mlanagan/RemoteHF/BARC Remote HF Presentation.pptx

## BARC Remote HF

## System Schematic – No Remote HF

SteppIR

40/80m EFHW

Rotator
Pwr/Signals

SDA100

Yeasu
G-800DXA

Feed Line

CI-V
Freq Info

Feed Line

ANT
SW

IC7300

## System Schematic – With Remote HF

SteppIR

40/80m EFHW

Rotator
Pwr/Signals

Yeasu
G-800DXA

SDA100

Data In

Feed Line

Feed Line

Data Out

Rot Ext Ctrl

Internet

Home PC

USB

Remote HF

CI-V
Freq Info

IC7300

Feed Line

## Home PC – Antenna/Rotator Control

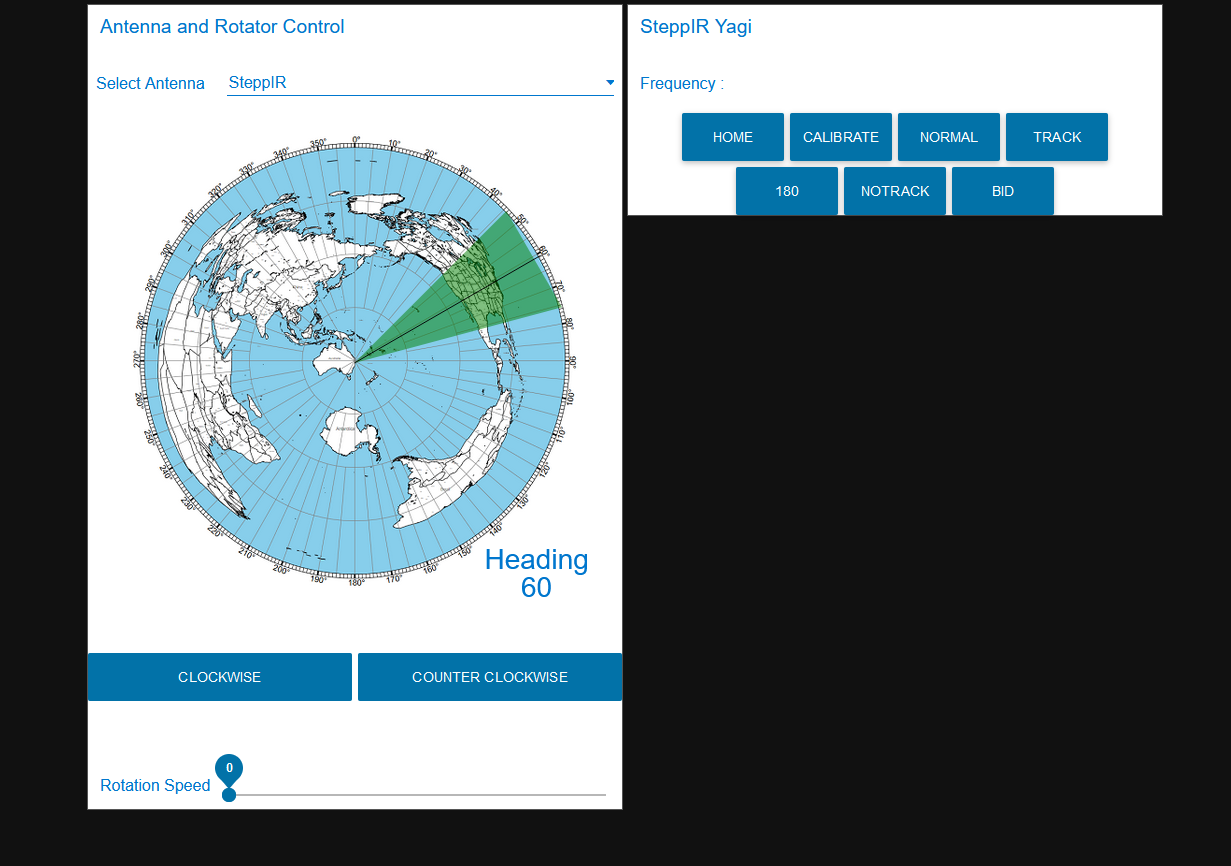
[picture p1: figure]

Select Antenna

Control the SteppIR

Current Antenna Heading

Rotate the Antenna
CW/CCW

Control the speed of rotation

## Home PC – WFView

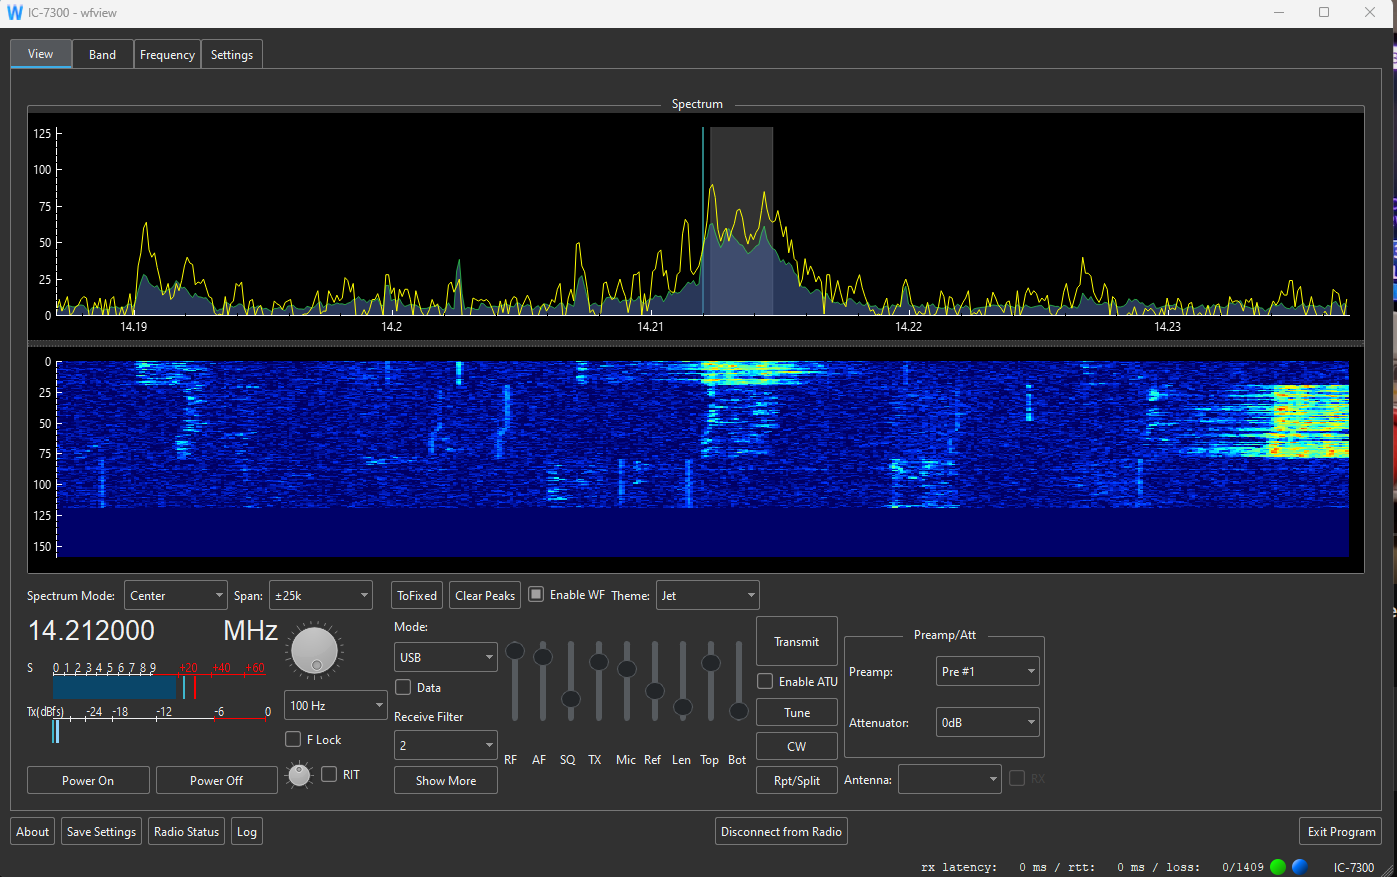
[picture p2: figure]

Frequency Graph

Waterfall

PTT

Frequency/S Meter/

Soft power on/off the radio

Radio settings

## Permissions

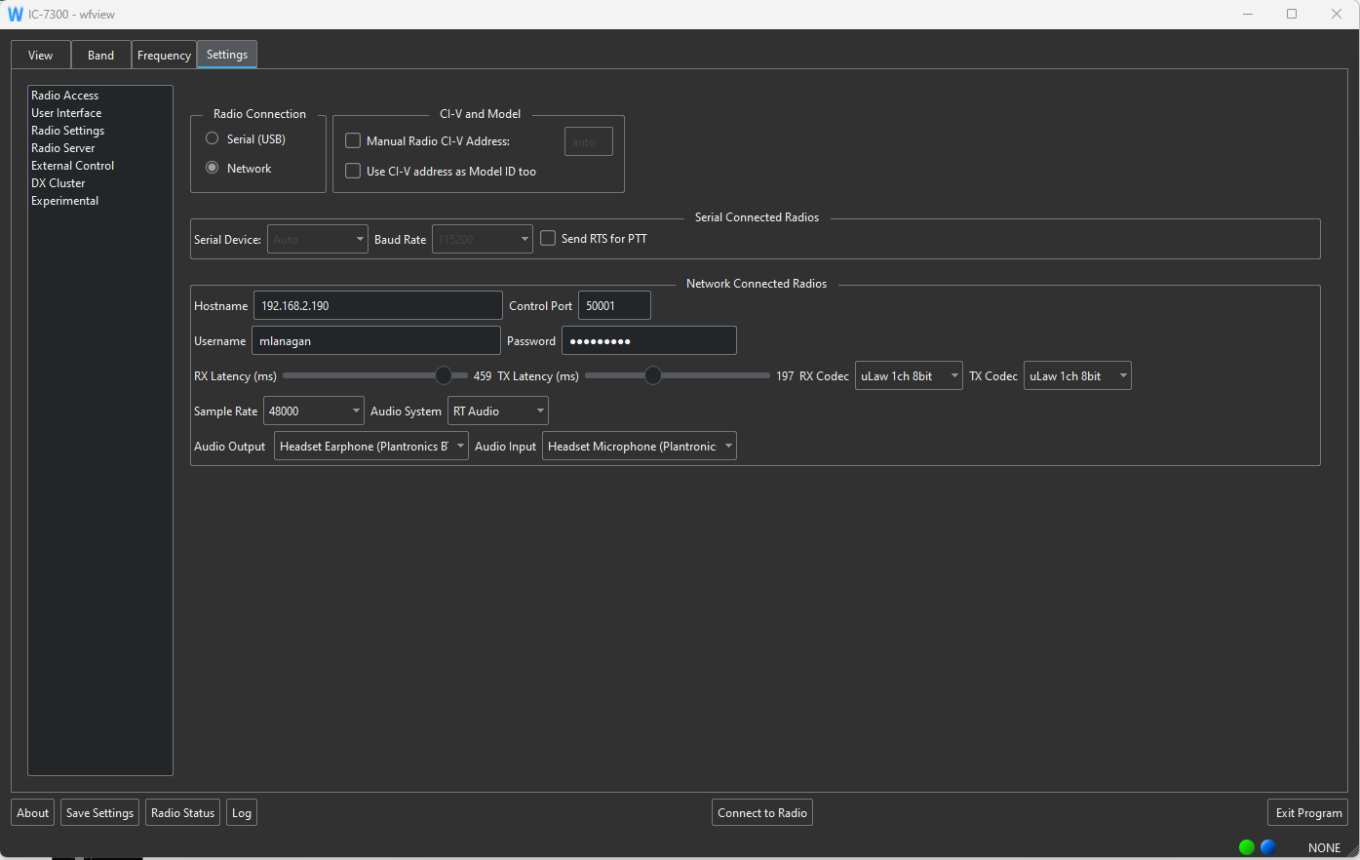
[picture p3: figure]

## VPN
