mlanagan/RemoteHF/NodeRed/Azimuthal Map 500 pixel.png

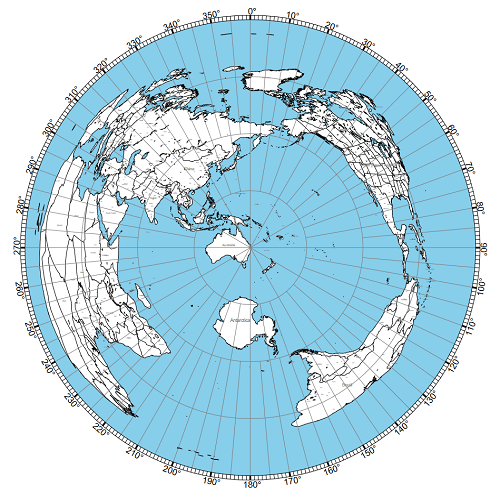
NodeRed/Azimuthal Map 500 pixel.png
