mlanagan/RemoteHF/Simulations/Linear DC Signal Opto-Isolator _ Optocoupler Circuit.png

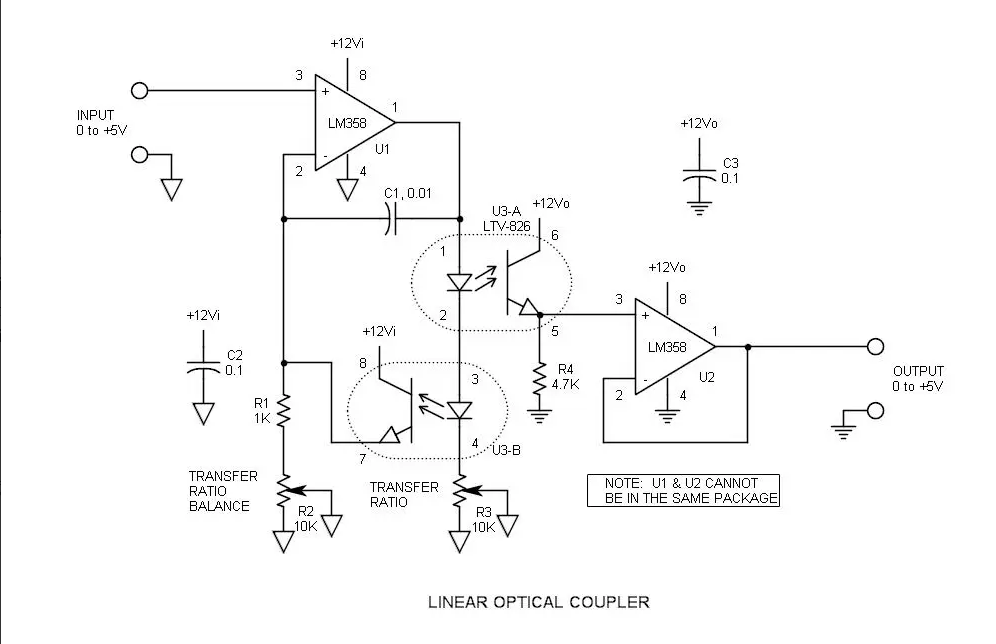
Simulations/Linear DC Signal Opto-Isolator _ Optocoupler Circuit.png
