mlanagan/RemoteHF/Costs/Remote HF Costs.xlsx

Item | Purchase Cost | QTY Ordered | Single Cost | QTY Used | Cost | Invoice | Notes
PCB - Remote HF | $44.40 | 5 | $8.88 | 5 | $44.40 | Remote HF invoice.pdf | Only used 1, but included full cost as part of the project
PCB - Remote HF PSU | $15.26 | 5 | $3.05 | 5 | $15.26 | Remote HF PSU invoice.pdf | Only used 2, but included full cost as part of the project
SMA Connectors | $31.00 | 5 | $6.20 | 5 | $31.00 | 7037128.pdf
STANDOFF, HEX FEMALE M2.5 | $7.62 | 10 | $0.76 | 4 | $3.05 | 7037128.pdf | Included what was used, remainder to VK4MWL spares
Pan Head Screw M2.5 | $3.58 | 100 | $0.04 | 8 | $0.29 | 7037128.pdf | Included what was used, remainder to VK4MWL spares
L7812CV | $3.08 | 5 | $0.62 | 2 | $1.23 | 7116739.pdf | Included what was used, remainder to VK4MWL spares
T491A224K035AT CAP, 0.22μF | $3.51 | 10 | $0.35 | 4 | $1.40 | 7116739.pdf | Included what was used, remainder to VK4MWL spares
TIP42C TRANSISTOR | $8.70 | 6 | $1.45 | 2 | $2.90 | 7116739.pdf | Included what was used, remainder to VK4MWL spares
ESK108M035AL3AA CAP, 1000μF | $8.25 | 10 | $0.82 | 4 | $3.30 | 7116739.pdf | Included what was used, remainder to VK4MWL spares
CONNECTOR, HEADER, 3POS | $4.21 | 10 | $0.42 | 2 | $0.84 | 7116739.pdf | Included what was used, remainder to VK4MWL spares
CONTACT, SOCKET | $2.94 | 30 | $0.10 | 6 | $0.59 | 7116739.pdf | Included what was used, remainder to VK4MWL spares
CRGCQ2512J3R3 RES, 3R3, 5%, 2512 | $3.77 | 10 | $0.38 | 2 | $0.75 | 7116739.pdf | Included what was used, remainder to VK4MWL spares
GBU401 BRIDGE RECTIFIER, 100V, 4A | $6.44 | 4 | $1.61 | 4 | $6.44 | 7116739.pdf
INLET, IEC, DPST, WITH FUSE HOLDER | $8.27 | 1 | $8.27 | 1 | $8.27 | 7111721.pdf
L7805CV | $2.58 | 5 | $0.52 | 2 | $1.03 | 7111721.pdf | Included what was used, remainder to VK4MWL spares
SIL PAD | $4.58 | 10 | $0.46 | 6 | $2.75 | 7111721.pdf | Included what was used, remainder to VK4MWL spares
31-35-25GFN BUSH, TO-220 | $2.24 | 10 | $0.22 | 6 | $1.34 | 7111721.pdf | Included what was used, remainder to VK4MWL spares
CONNECTOR, RCPT, 3POS | $1.01 | 10 | $0.10 | 2 | $0.20 | 7111721.pdf | Included what was used, remainder to VK4MWL spares
Heatsink Large | $24.88 | 2 | $12.44 | 2 | $24.88 | 8174468141636406.png
Heatsink Small | $8.34 | 1 | $8.34 | 1 | $8.34 | 8174468141656406.png
SO239 to SMA | $4.29 | 1 | $4.29 | 1 | $4.29 | 8168797981976406.png
SMA to SMA Cable | $2.39 | 1 | $2.39 | 1 | $2.39 | 8168672447006406.png
USB Isolator | $16.47 | 1 | $16.47 | 1 | $16.47 | 8163513651936406.png
PS2 Connector | $3.67 | 5 | $0.73 | 1 | $0.73 | 8158063447796406.png | Included what was used, remainder to VK4MWL spares
PS2 Cable | $11.32 | 1 | $11.32 | 1 | $11.32 | 8158063607796406.png
PCB Screw connectors | $5.23 | 10 | $0.52 | 4 | $2.09 | 8158380707686406.png | Included what was used, remainder to VK4MWL spares
Headers for Raspberry Pi | $7.27 | 10 | $0.73 | 1 | $0.73 | 8157976885486406.png | Included what was used, remainder to VK4MWL spares
DB9 Connectors | $2.65 | 2 | $1.32 | 1 | $1.32 | 8158428130806406.png | Included what was used, remainder to VK4MWL spares
NDS7002A MOSFETS | $15.55 | 50 | $0.31 | 17 | $5.29 | 8157449323486406.png | Included what was used, remainder to VK4MWL spares
MAX202 | $4.23 | 10 | $0.42 | 1 | $0.42 | 8157855993506406.png | Included what was used, remainder to VK4MWL spares
Rasberry Pi | $135.30 | 1 | $135.30 | 1 | $135.30 | 1000379996.png
Total | $403.03 |  |  |  | $338.63
