mlanagan/RemoteHF/Costs/Remote HF invoice.pdf

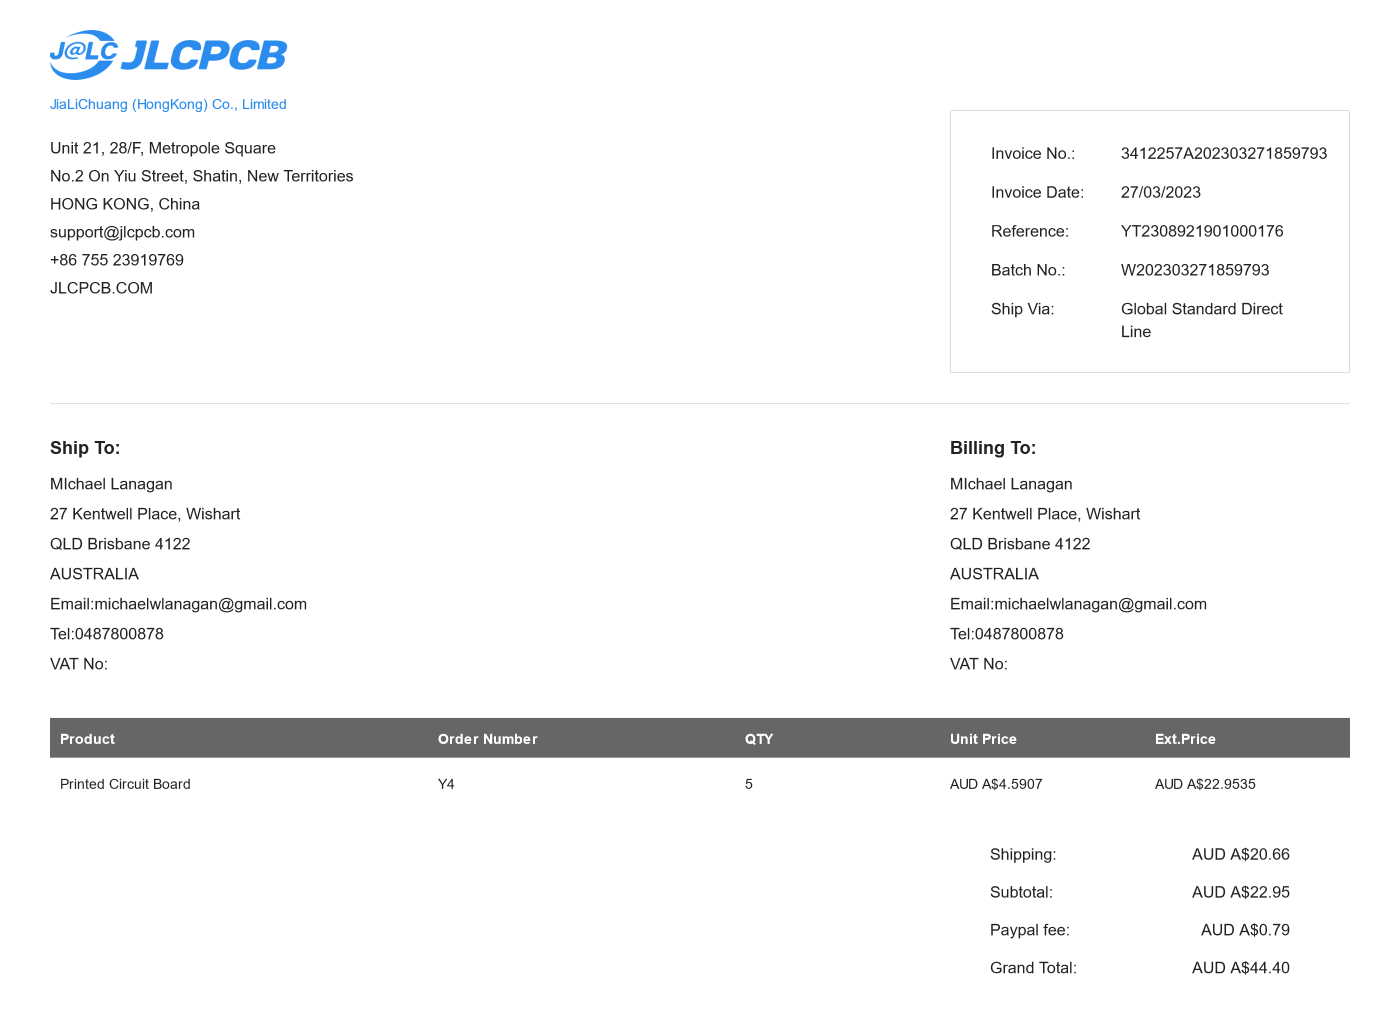
[picture p6: figure]
