mlanagan/RemoteHF/Costs/Remote HF PSU invoice.pdf

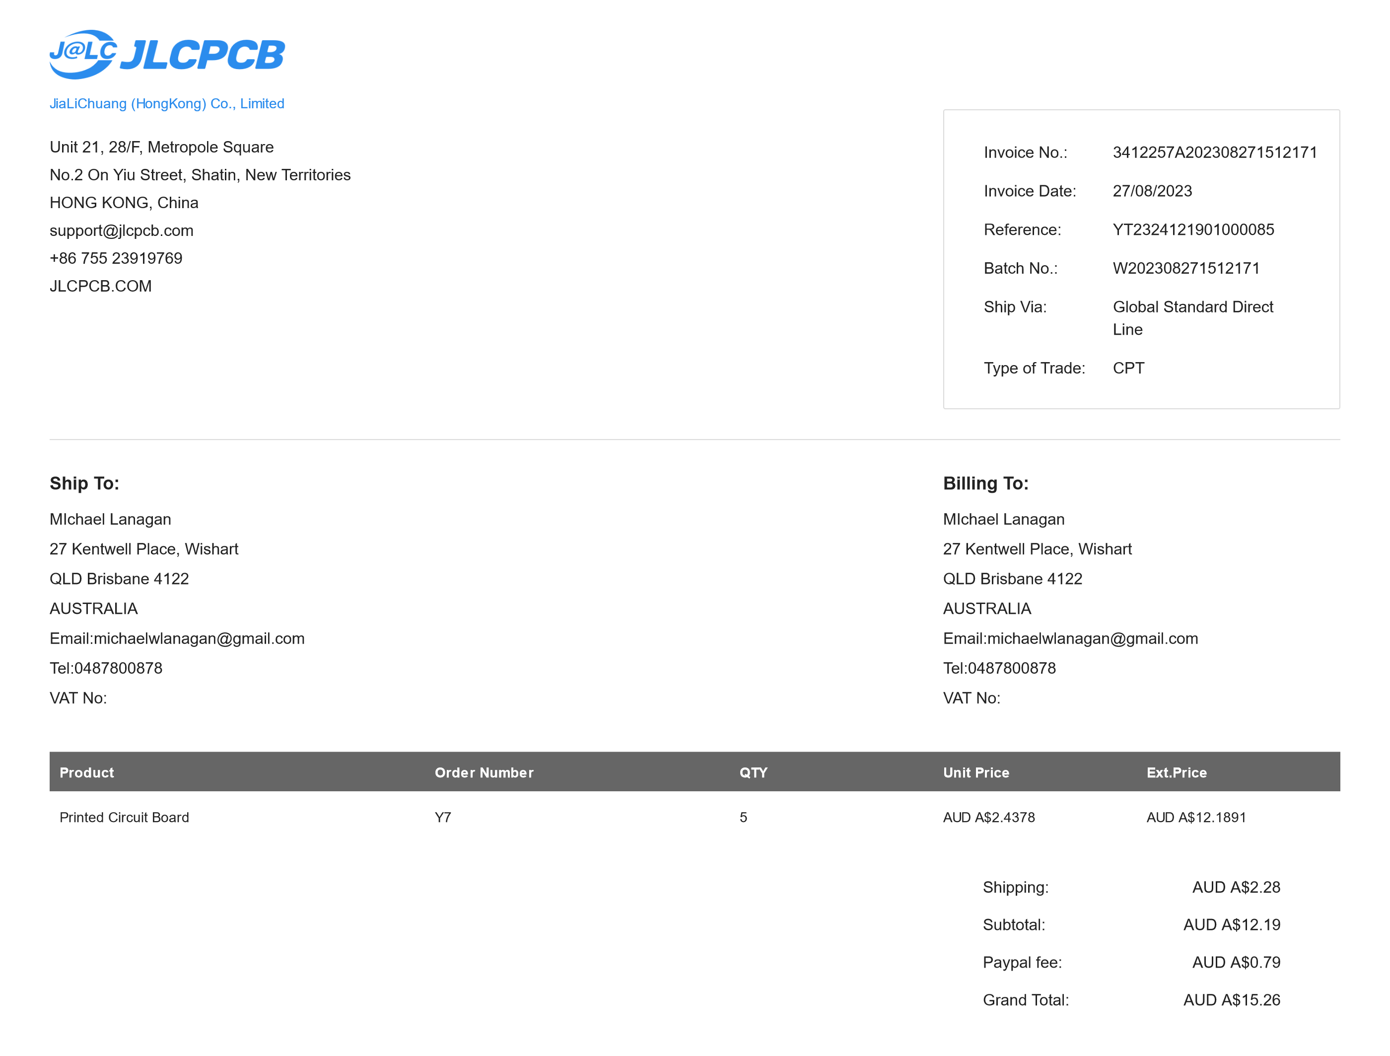
[picture p7: figure]
