mlanagan/RemoteHF/Costs/1000379996.png

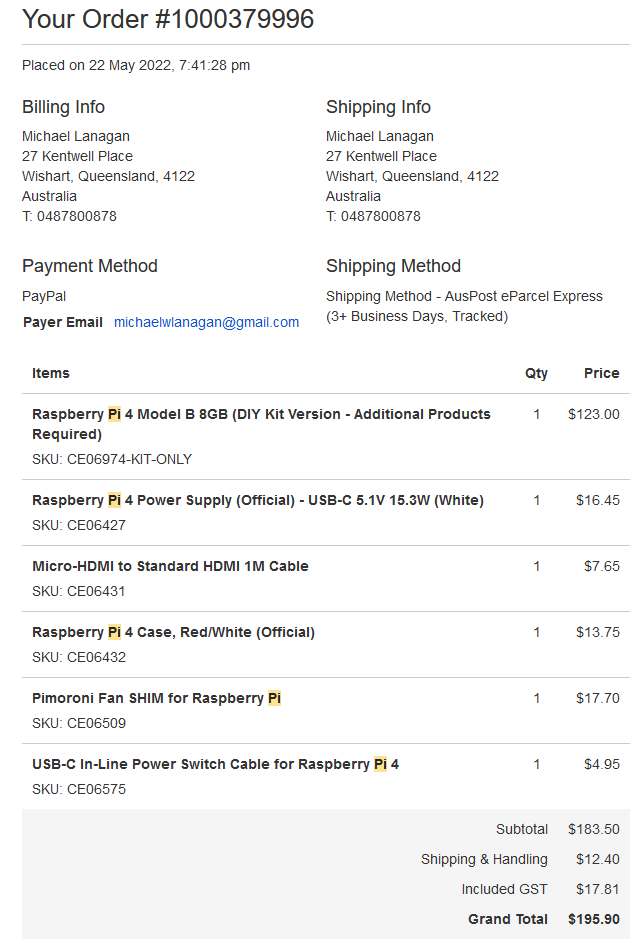
Costs/1000379996.png
