mlanagan/RemoteHF/Costs/8157449323486406.png

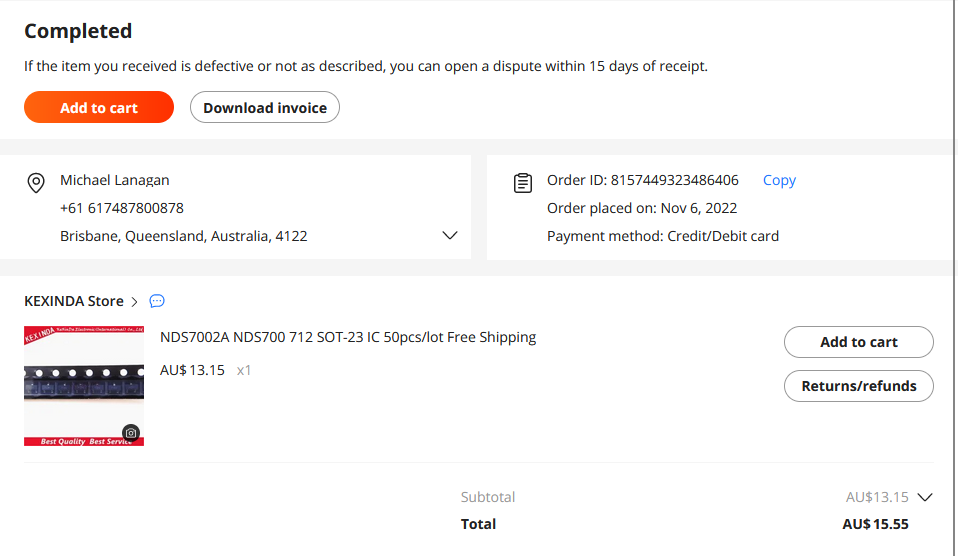
Costs/8157449323486406.png
