mlanagan/RemoteHF/Costs/8157855993506406.png

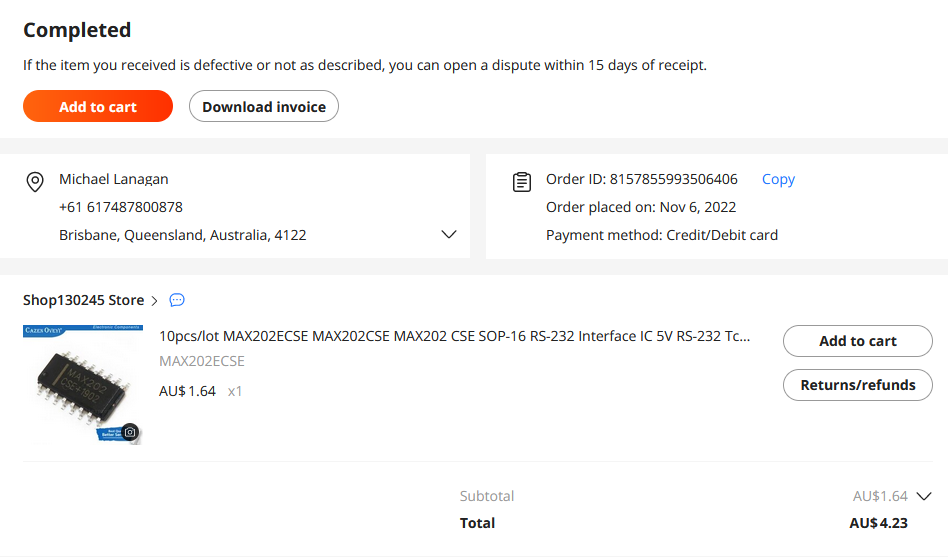
Costs/8157855993506406.png
