mlanagan/RemoteHF/Costs/8158063447796406.png

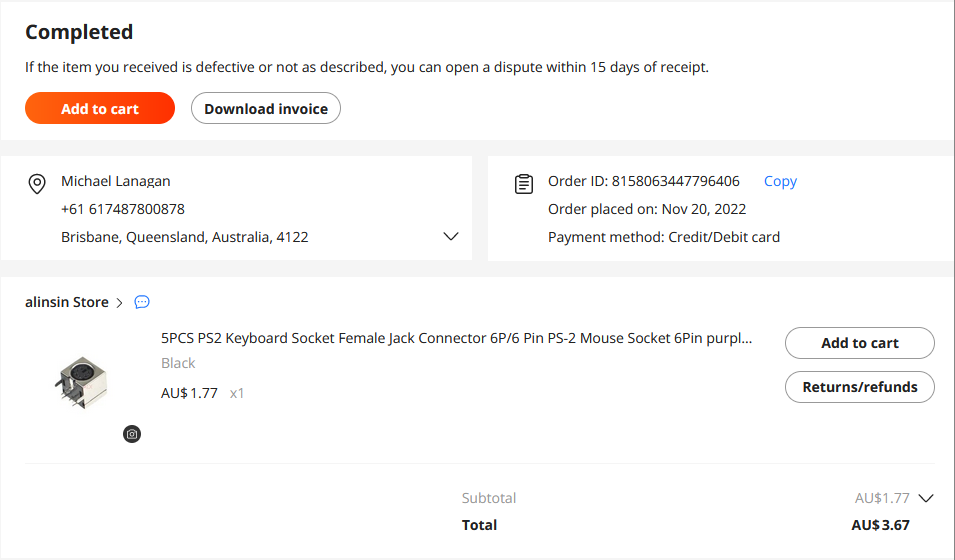
Costs/8158063447796406.png
