mlanagan/RemoteHF/Costs/8158380707686406.png

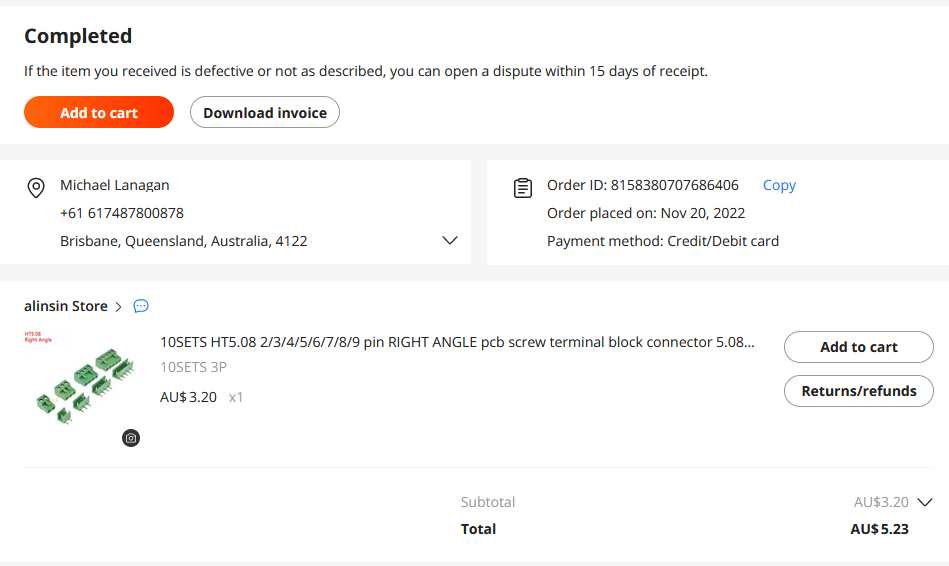
Costs/8158380707686406.png
