mlanagan/RemoteHF/Costs/8158428130806406.png

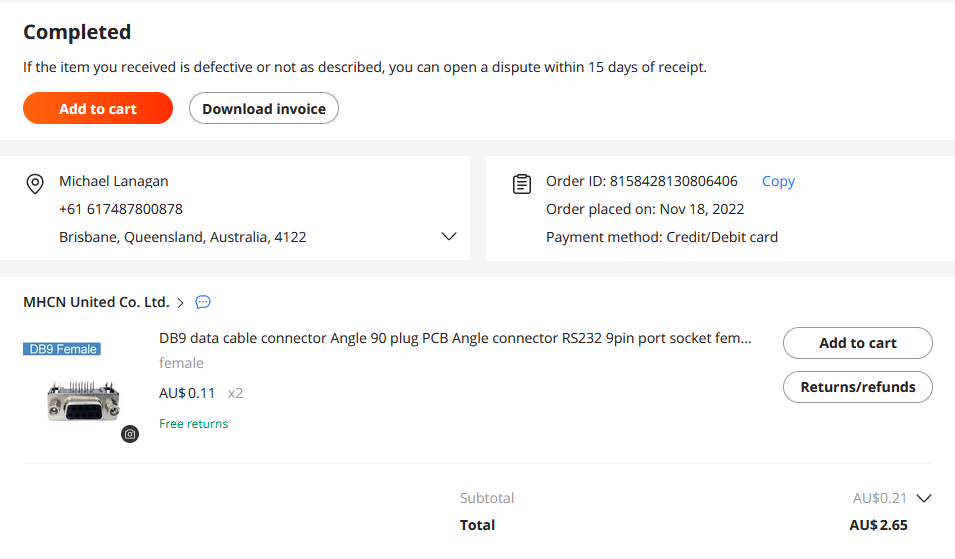
Costs/8158428130806406.png
