mlanagan/RemoteHF/Costs/8163513651936406.png

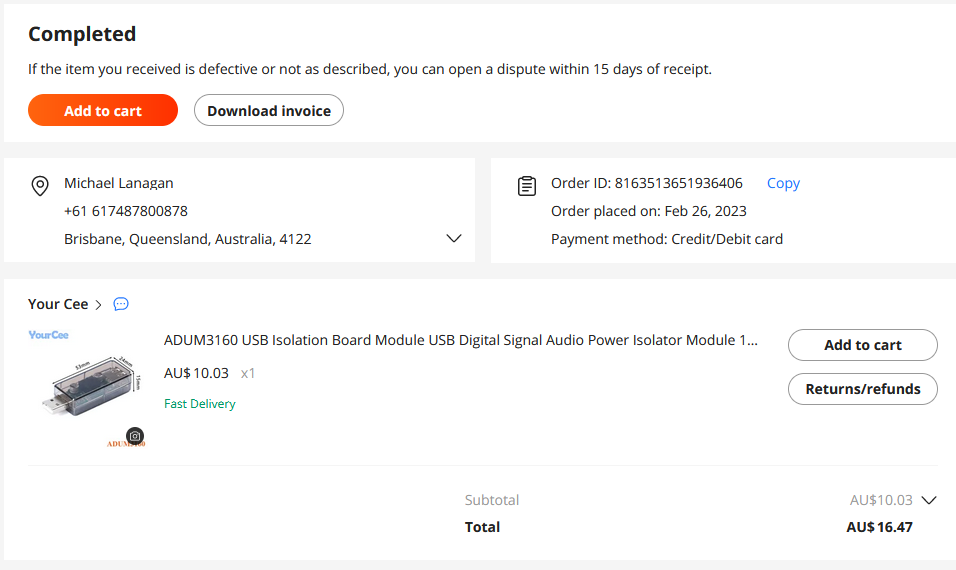
Costs/8163513651936406.png
