mlanagan/RemoteHF/Costs/8168672447006406.png

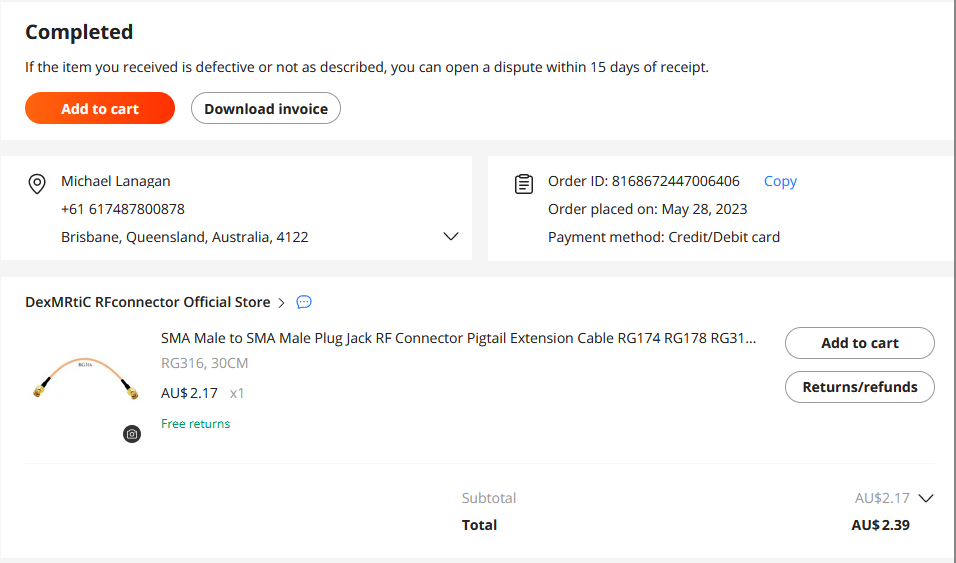
Costs/8168672447006406.png
