mlanagan/RemoteHF/Costs/8174468141636406.png

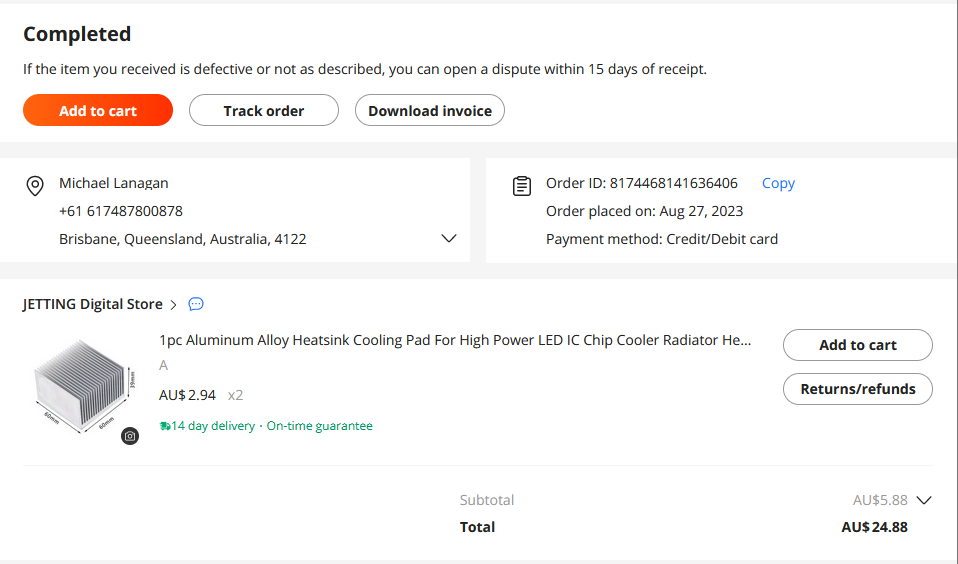
Costs/8174468141636406.png
