mlanagan/RemoteHF/Costs/8174468141656406.png

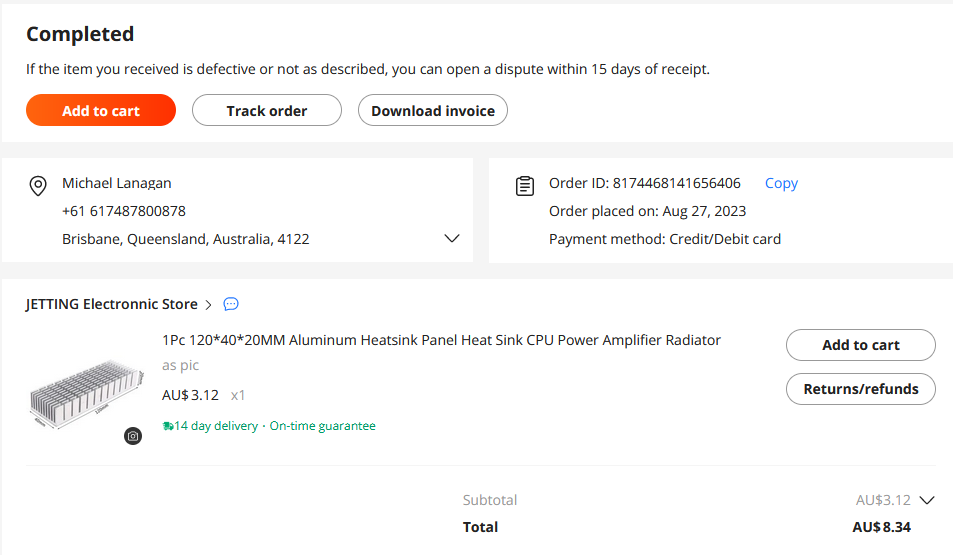
Costs/8174468141656406.png
