mlanagan/RemoteHF/NodeRed/Installed Nodes.png

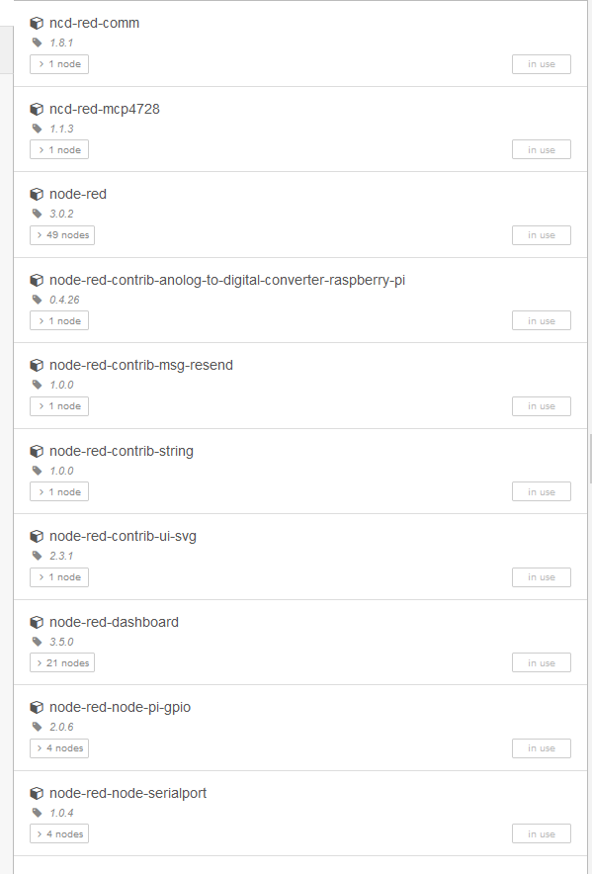
NodeRed/Installed Nodes.png
