mlanagan/RemoteHF/PowerSupply/PowerSupply.pdf

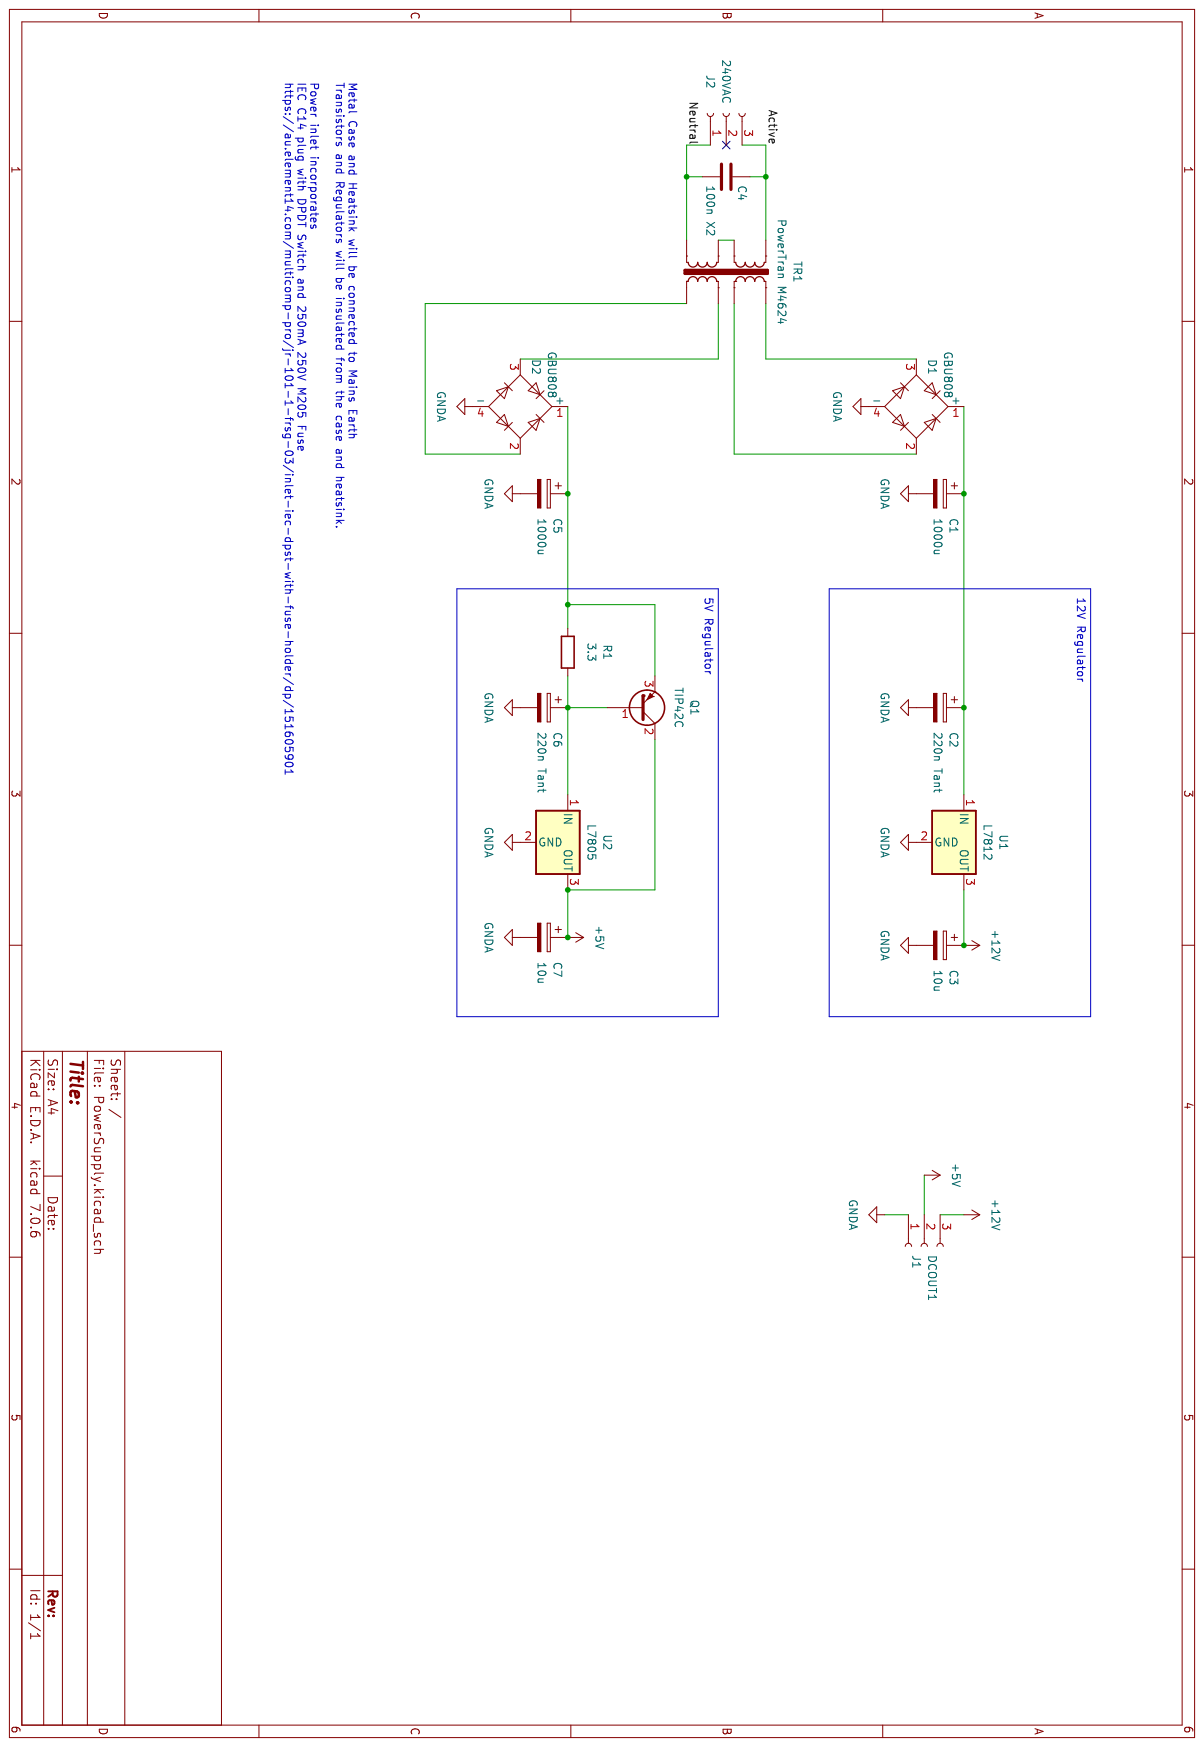
[picture p19: page 1]
