mlanagan/RemoteHF/NodeRed/AzimuthalMap.pdf

0° 350°

# Azimuthal Map

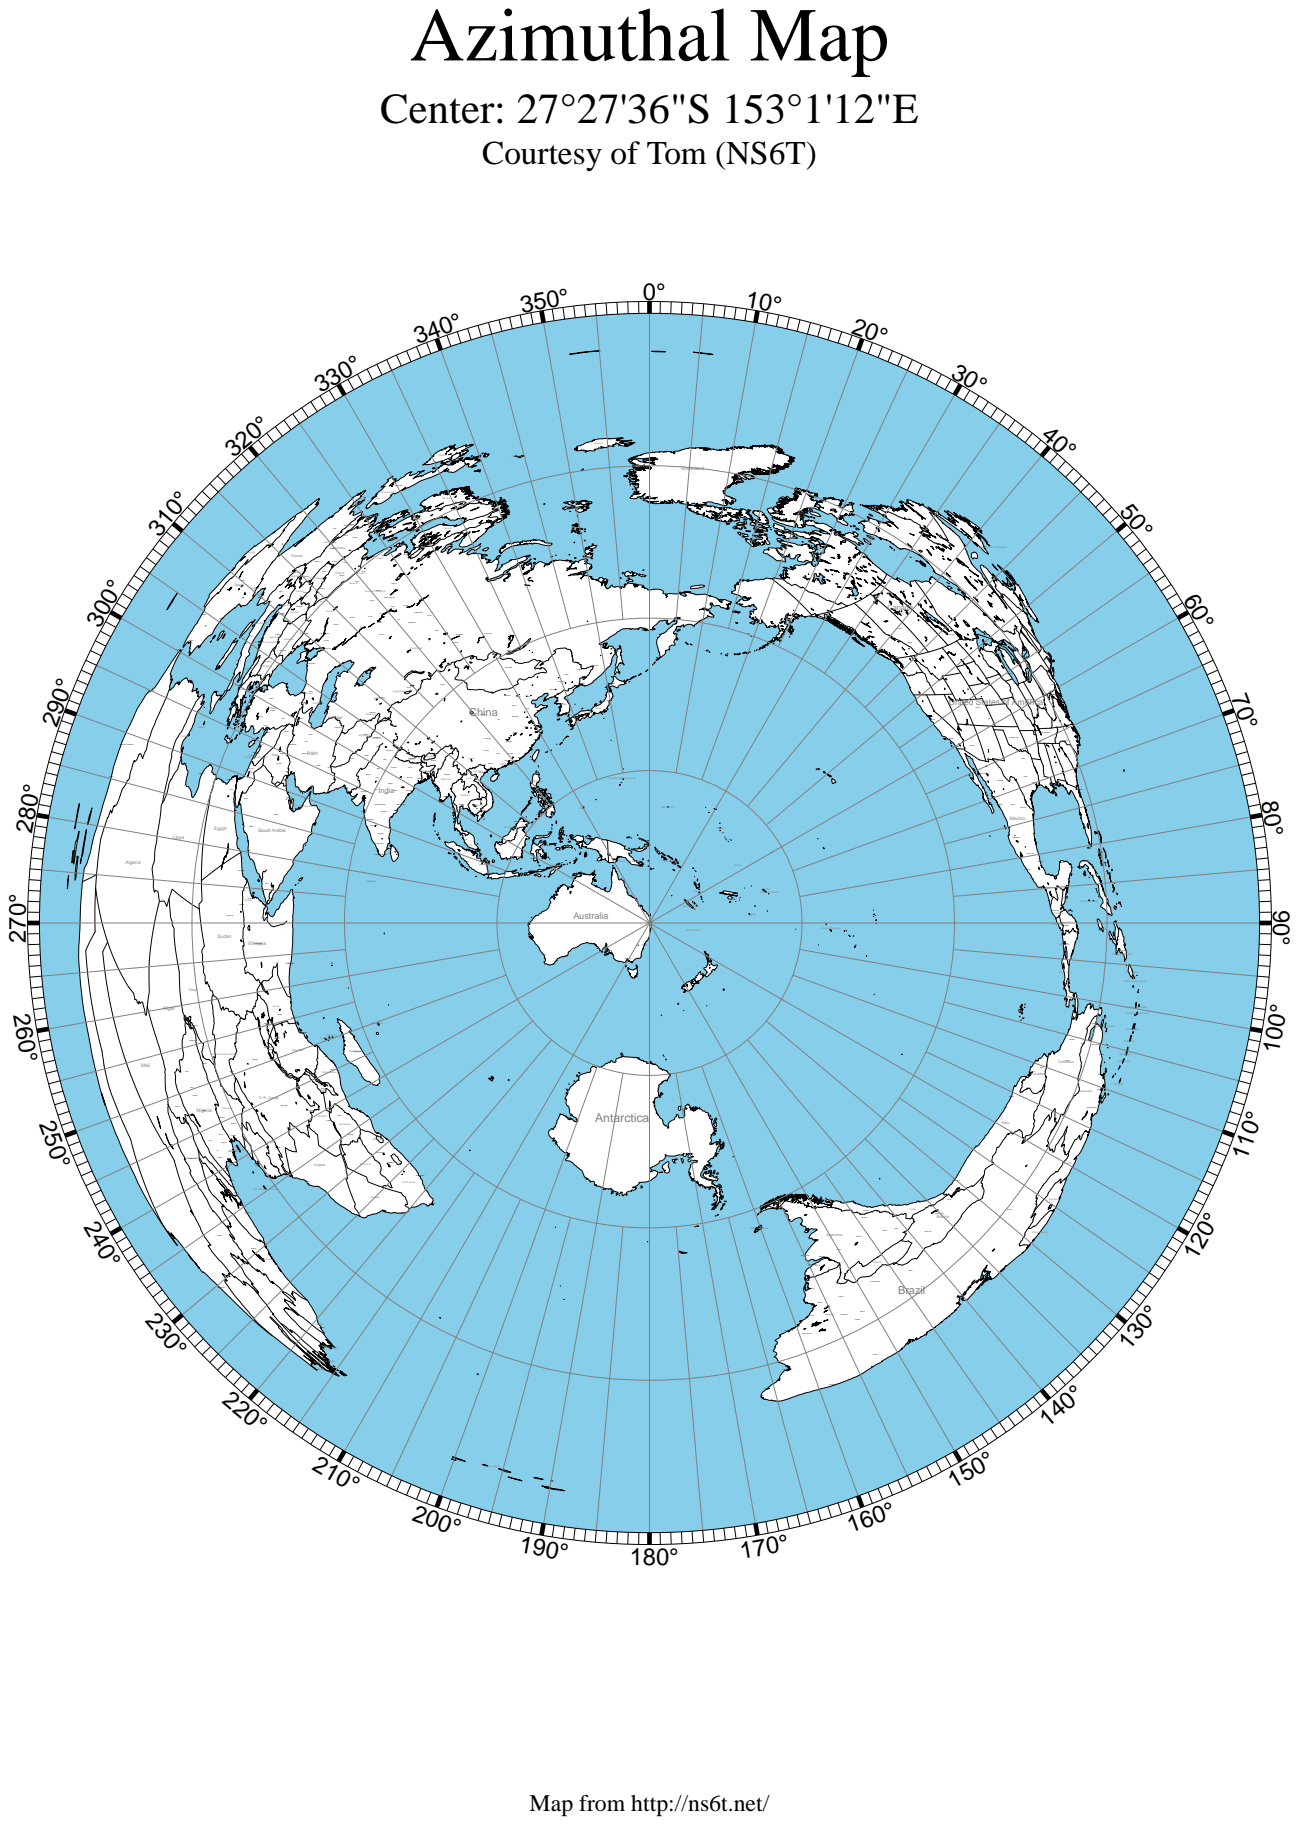
[picture p20: page 1]
Antarctica; Cote d'Ivoire; Afghanistan; Albania; Algeria; American Samoa; Andorra; Angola; Argentina; Armenia; Aruba; Australia; Austria; Azerbaijan; Bahamas; Bahrain; Bangladesh; Barbados; Belarus; Belgium; Belize; Bhutan; Bolivia; Botswana; Brazil; Brunei Darussalam; Bulgaria; Burkina Faso; Burundi; Cambodia; Cameroon; Canada; Cape Verde; Cayman Islands; Chad; Chile; China; Colombia; Comros; Congo; D. R. Congo; Costa Rica; Croatia; Cuba; Cyprus; Czech Republic; Denmark; Djibouti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

Center: 27°27'36"S 153°1'12"E
Courtesy of Tom (NS6T)

Saint Pierre and Miquelon

Bosnia and Herzegovina

Rostov-na-Donu

United States of America

Phoenix San Diego

Bayrout
Lebanon
Syrian Arab Republic

Northern Mariana Islands

Qatar
United Arab Emirates

Ho Chi Minh City Bombay

Papua New Guinea

Port-au-Prince
Haiti

British Virgin Islands

Saint Kitts and Nevis

Antigua and Barbuda

Dar es Salaam

Central African Republic

Sao Tome and Principe

Mar del Plata

Rio de Janeiro

Map from http://ns6t.net/
