mlanagan/RemoteHF/Simulations/AnalogOpto test.asc

C1: cap; 0.1µ
Q1: npn; 2N3904
R1: res; 1k
R2: res; 470
R3: res; 100
R5: res; 10k
R6: res; 1k
R7: res; 1k
U1: LT1490
U2: PC817A
U3: PC817A
V1: voltage; 12
V2: voltage; 12
V3: voltage; SINE(2.5 2.5 1)
Named nets: 0, Output, Input, Viso
.tran 10
