mlanagan/RemoteHF/Simulations/Draft1.asc

C1: cap; 10µ
M1: nmos; BSP89
R2: res; 33k
R3: res; 1k
V1: voltage; PULSE(0 5 0 .005 .005 .005 .01 100)
V2: voltage; PULSE(0 5 0 .005 .005 .11 .22 10)
Named nets: 0, OUT
.tran 2
