mlanagan/RemoteHF/Simulations/RS232 ISO.asc

M1: nmos; IPB042N03L
R1: res; 220
R3: res; 220
R4: res; 220
R5: res; 270
U1: PC817A
U2: PC817A
V1: voltage; PULSE(0 3.3 0 1u 1u 1m 2m 1000)
V2: voltage; 5
V3: voltage; 5
V4: voltage; PULSE(0 5 0 1u 1u 1m 2m 1000)
V5: voltage; 3.3
Named nets: 0, RXOUTISO, RXOUT, TXINISO, TXIN
.tran .1
