mlanagan/RemoteHF/PowerSupply/PowerSupply.kicad_pcb

## KiCad design PowerSupply/PowerSupply.kicad_pcb (2023-09-07)

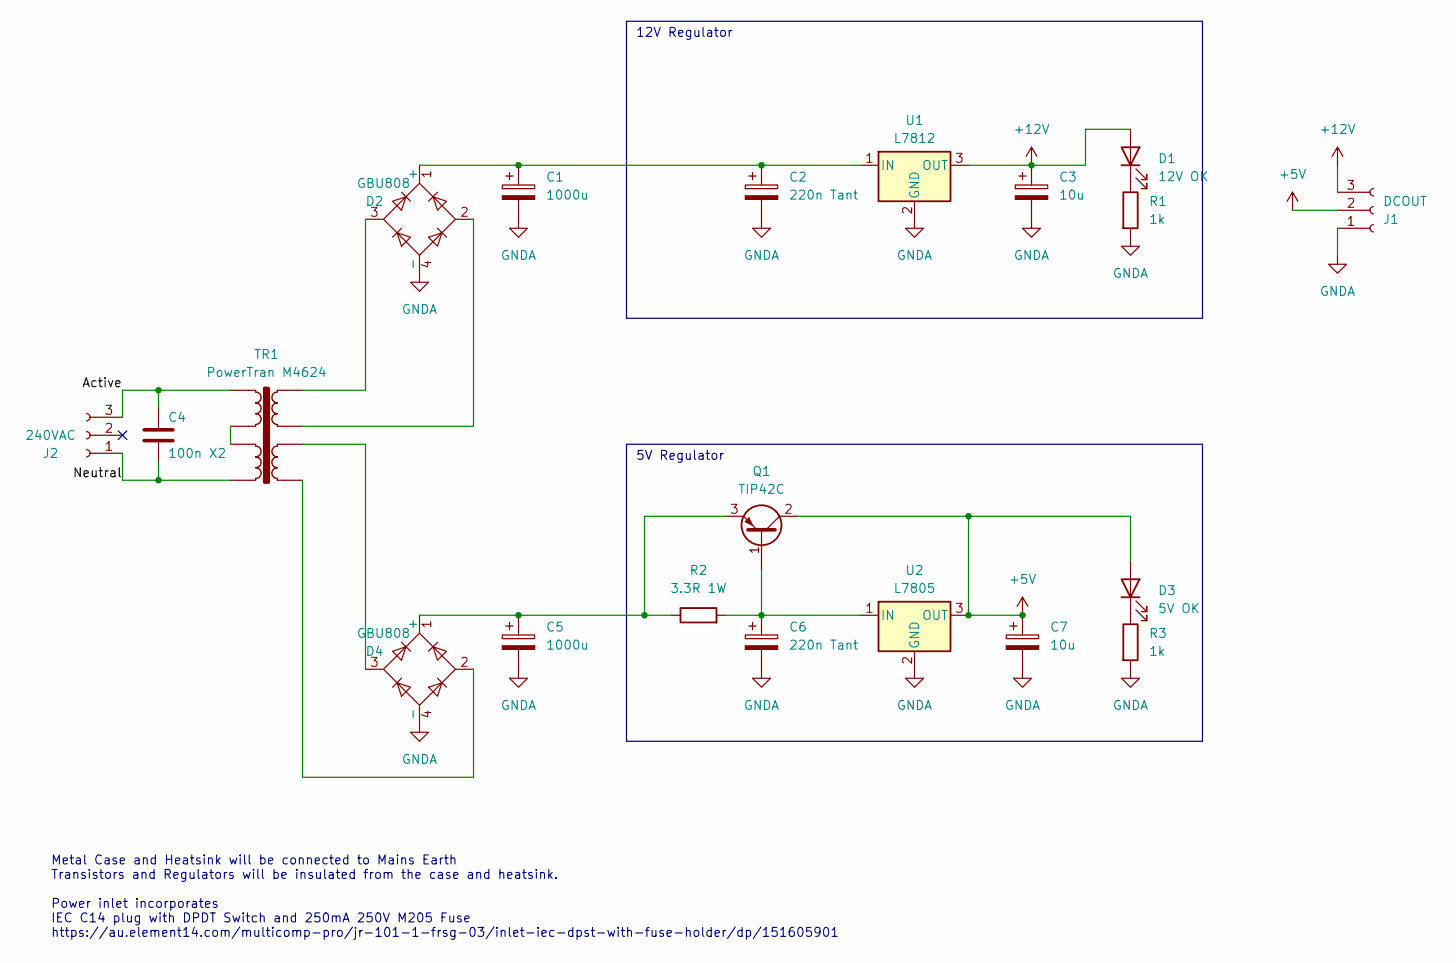
[picture p21: schematic PowerSupply.kicad_sch]

Parts:
C1, C5: 1000u; CP_Radial_D13.0mm_P5.00mm
C2, C6: 220n Tant; CP_EIA-3216-18_Kemet-A
C3, C7: 10u; CP_Elec_5x5.7
C4: 100n X2; C_Rect_L18.0mm_W5.0mm_P15.00mm_FKS3_FKP3
D1: 12V OK; LED_0805_2012Metric
D2, D4: GBU808; Diode_Bridge_Vishay_GBU
D3: 5V OK; LED_0805_2012Metric
J1: DCOUT; ScrewTermConnector 1x3
J2: 240VAC; Molex_KK-396_5273-03A_1x03_P3.96mm_Vertical
Q1: TIP42C; TO-220-3_Vertical
R1, R3: 1k; R_0805_2012Metric
R2: 3.3R 1W; R_2512_6332Metric
TR1: PowerTran M4624
U1: L7812; TO-220-3_Vertical
U2: L7805; TO-220-3_Vertical

Connections:
+5V: C7.1, D3.2 (A), J1.2, Q1.2 (C), U2.3 (OUT)
+12V: C3.1, D1.2 (A), J1.3, U1.3 (OUT)
/Active: C4.1, J2.3, TR1.1
/Neutral: C4.2, J2.1, TR1.4
GNDA: C1.2, C2.2, C3.2, C5.2, C6.2, C7.2, D2.4 (-), D4.4 (-), J1.1, R1.2, R3.2, U1.2 (GND), U2.2 (GND)
unnamed: D1.1 (K), R1.1
unnamed: C1.1, C2.1, D2.1 (+), U1.1 (IN)
unnamed: D2.2, TR1.7
unnamed: D2.3, TR1.8
unnamed: D3.1 (K), R3.1
unnamed: C5.1, D4.1 (+), Q1.3 (E), R2.1
unnamed: D4.2, TR1.5
unnamed: D4.3, TR1.6
unnamed: C6.1, Q1.1 (B), R2.2, U2.1 (IN)
unnamed: TR1.2, TR1.3

Notes on the sheet:
Metal Case and Heatsink will be connected to Mains Earth Transistors and Regulators will be insulated from the case and heatsink. Power inlet incorporates IEC C14 plug with DPDT Switch and 250mA 250V M205 Fuse https://au.element14.com/multicomp-pro/jr-101-1-frsg-03/inlet-iec-dpst-with-fuse-holder/d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
12V Regulator
5V Regulator

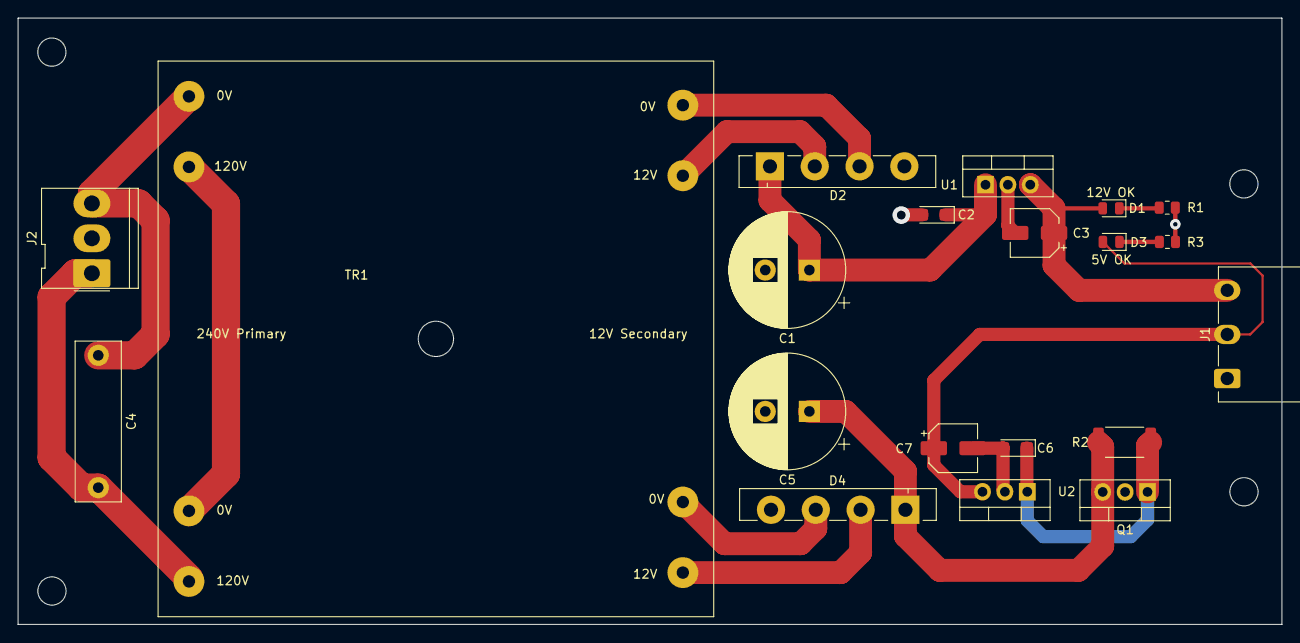
[picture p22: board PowerSupply.kicad_pcb from above]

Board: 2 copper layers, 143.3 x 68.8 mm, 20 parts (0 on the bottom side), 15 nets.
