mlanagan/RemoteHF/KicadPCB/RemoteHF.kicad_pcb

## KiCad design KicadPCB/RemoteHF.kicad_pcb (2023-09-03)

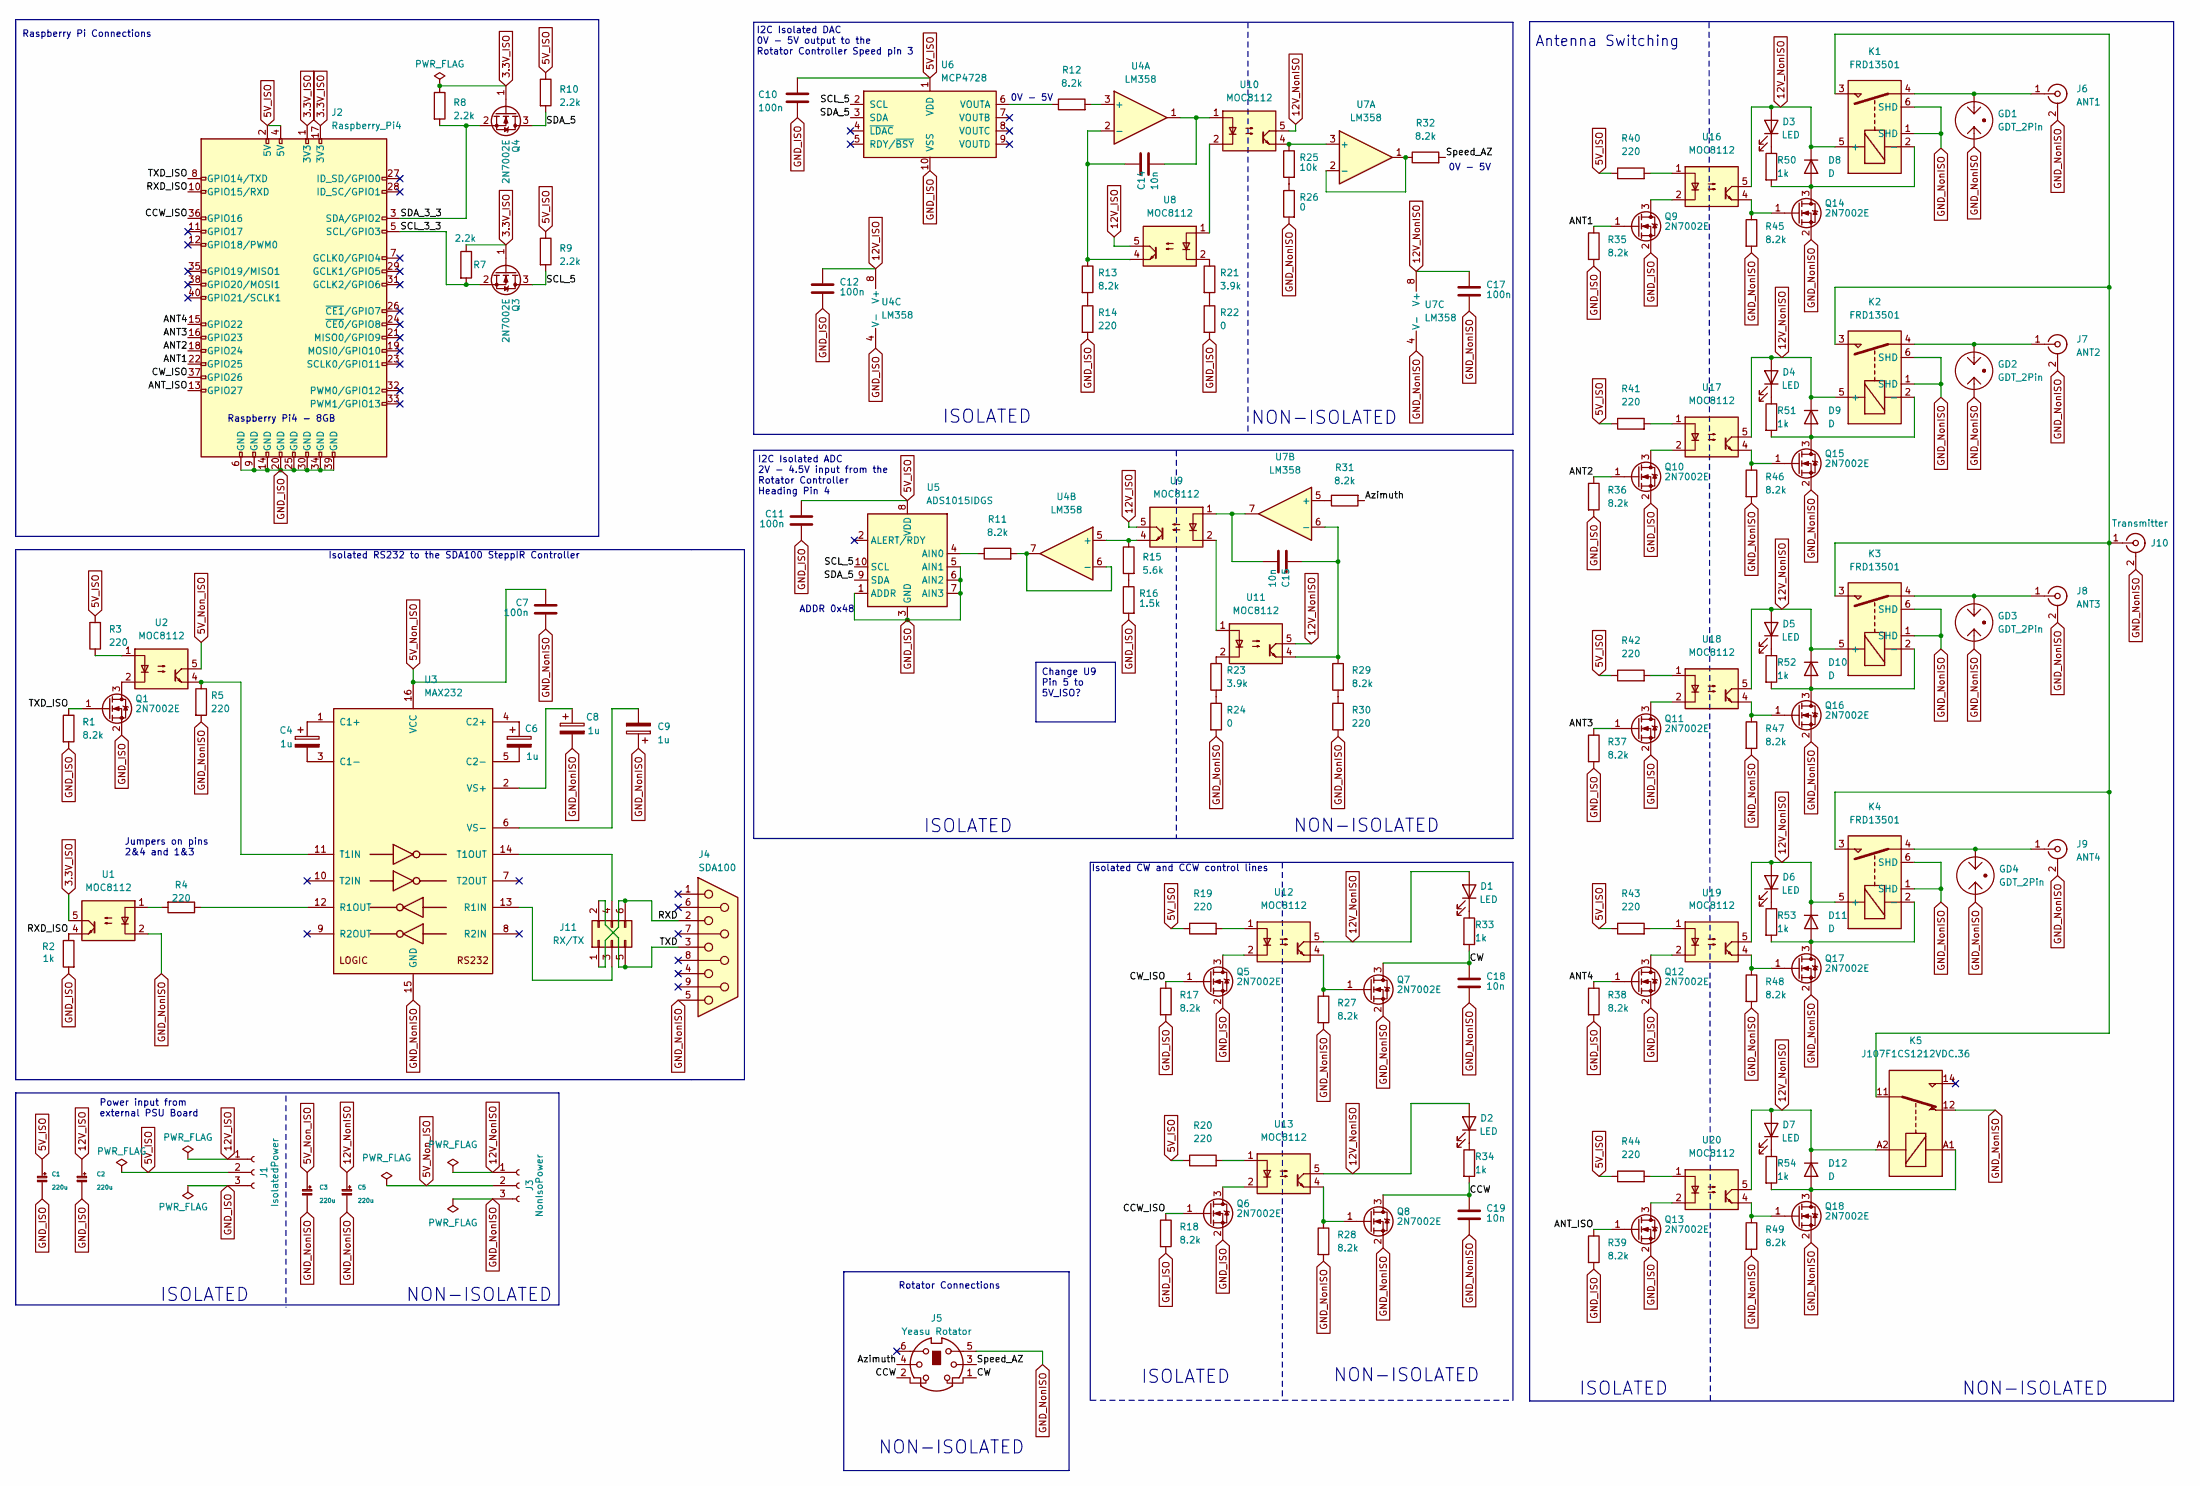
[picture p23: schematic RemoteHF.kicad_sch, Remote HF Controller Board - VK4MWL]

Parts:
C1, C2, C3, C5: 220u; CP_Elec_10x10.5
C4, C6, C8, C9: 1u; C_0805_2012Metric
C7, C10, C11, C12, C17: 100n; C_0805_2012Metric
C14, C15, C18, C19: 10n; C_0805_2012Metric
D1, D2, D3, D4, D5, D6, D7: LED; LED_0805_2012Metric
D8, D9, D10, D11, D12: D; D_SOD-123F
GD1, GD2, GD3, GD4: GDT_2Pin; GDT Bourns 2053
J1: IsolatedPower; ScrewTermConnector 1x3
J2: Raspberry_Pi4; Raspberry Pi 4B
J3: NonIsoPower; ScrewTermConnector 1x3
J4: SDA100; DSUB-9_Female_Horizontal_P2.77x2.84mm_EdgePinOffset7.70mm_H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
J5: Yeasu Rotator; Connector_Mini-DIN_Female_6Pin_2rows
J6: ANT1; SMA_Amphenol_901-144_Vertical_Lge
J7: ANT2; SMA_Amphenol_901-144_Vertical_Lge
J8: ANT3; SMA_Amphenol_901-144_Vertical_Lge
J9: ANT4; SMA_Amphenol_901-144_Vertical_Lge
J10: Transmitter; SMA_Amphenol_901-144_Vertical_Lge
J11: RX/TX; PinHeader_2x03_P2.54mm_Vertical
K1, K2, K3, K4: FRD13501; Relay_Crydom_FRD13501
K5: J107F1CS1212VDC.36; Relay_SPDT_Finder_36.11
Q1, Q3, Q4, Q5, Q6, Q7, Q8, Q9, Q10, Q11, Q12, Q13, Q14, Q15, Q16, Q17, Q18: 2N7002E; SOT-23
R1, R11, R12, R13, R17, R18, R27, R28, R29, R31, R32, R35, R36, R37, R38, R39, R45, R46, R47, R48, R49: 8.2k; R_0805_2012Metric
R2, R33, R34, R50, R51, R52, R53, R54: 1k; R_0805_2012Metric
R3, R4, R5, R14, R19, R20, R30, R40, R41, R42, R43, R44: 220; R_0805_2012Metric
R7, R8, R9, R10: 2.2k; R_0805_2012Metric
R15: 5.6k; R_0805_2012Metric
R16: 1.5k; R_0805_2012Metric
R21, R23: 3.9k; R_0805_2012Metric
R22, R24, R26: 0; R_0805_2012Metric
R25: 10k; R_0805_2012Metric
U1, U2, U8, U9, U10, U11, U12, U13, U16, U17, U18, U19, U20: MOC8112; DIP-6_W7.62mm
U3: MAX232; SOP-16_3.9x9.9mm_P1.27mm
U4, U7: LM358; SOIC-8_3.9x4.9mm_P1.27mm
U5: ADS1015IDGS; VSSOP-10_3x3mm_P0.5mm
U6: MCP4728; MSOP-10_3x3mm_P0.5mm

Connections:
3.3V_ISO: J2.1 (3V3), J2.17 (3V3), Q3.1 (G), Q4.1 (G), R7.1, R8.1, U1.5
5V_ISO: C1.1, C10.1, C11.1, J1.2, J2.2 (5V), J2.4 (5V), R3.2, R9.1, R10.1, R19.1, R20.1, R40.1, R41.1, R42.1, R43.1, R44.1, U5.8 (VDD), U6.1 (VDD)
5V_Non_ISO: C3.1, C7.1, J3.2, U2.5, U3.16 (VCC)
12V_ISO: C2.1, C12.1, J1.1, U4.8 (V+), U8.5, U9.5
12V_NonISO: C5.1, C17.1, D1.2 (A), D2.2 (A), D3.2 (A), D4.2 (A), D5.2 (A), D6.2 (A), D7.2 (A), D8.1 (K), D9.1 (K), D10.1 (K), D11.1 (K), D12.1 (K), J3.1, K1.5 (+), K2.5 (+), K3.5 (+), K4.5 (+), K5.A2, U7.8 (V+), U10.5, U11.5, U12.5, U13.5, U16.5, U17.5, U18.5, U19.5, U20.5
/ANT1: J2.22 (GPIO25), Q9.1 (G), R35.1
/ANT2: J2.18 (GPIO24), Q10.1 (G), R36.1
/ANT3: J2.16 (GPIO23), Q11.1 (G), R37.1
/ANT4: J2.15 (GPIO22), Q12.1 (G), R38.1
/ANT_ISO: J2.13 (GPIO27), Q13.1 (G), R39.1
/Azimuth: J5.4, R31.2
/CCW: C19.1, J5.2, Q8.3 (D), R34.2
/CCW_ISO: J2.36 (GPIO16), Q6.1 (G), R18.1
/CW: C18.1, J5.1, Q7.3 (D), R33.2
/CW_ISO: J2.37 (GPIO26), Q5.1 (G), R17.1
/RXD: J4.2, J11.1, J11.6
/RXD_ISO: J2.10 (GPIO15/RXD), R2.1, U1.4
/SCL_3_3: J2.5 (SCL/GPIO3), Q3.2 (S), R7.2
/SCL_5: Q3.3 (D), R9.2, U5.10 (SCL), U6.2 (SCL)
/SDA_3_3: J2.3 (SDA/GPIO2), Q4.2 (S), R8.2
/SDA_5: Q4.3 (D), R10.2, U5.9 (SDA), U6.3 (SDA)
/Speed_AZ: J5.3, R32.2
/TXD: J4.3, J11.2, J11.5
/TXD_ISO: J2.8 (GPIO14/TXD), Q1.1 (G), R1.1
GND_ISO: C1.2, C2.2, C10.2, C11.2, C12.2, J1.3, J2.6 (GND), J2.9 (GND), J2.14 (GND), J2.20 (GND), J2.25 (GND), J2.30 (GND), J2.34 (GND), J2.39 (GND), Q1.2 (S), Q5.2 (S), Q6.2 (S), Q9.2 (S), Q10.2 (S), Q11.2 (S), Q12.2 (S), Q13.2 (S), R1.2, R2.2, R14.2, R16.2, R17.2, R18.2, R22.2, R35.2, R36.2, R37.2, R38.2, R39.2, U4.4 (V-), U5.1 (ADDR), U5.3 (GND), U5.5 (AIN1), U5.6 (AIN2), U5.7 (AIN3), U6.10 (VSS)
GND_NonISO: C3.2, C5.2, C7.2, C8.2, C9.1, C17.2, C18.2, C19.2, GD1.1, GD2.1, GD3.1, GD4.1, J3.3, J4.5, J5.5, J6.2 (Ext), J7.2 (Ext), J8.2 (Ext), J9.2 (Ext), J10.2 (Ext), K1.1 (SHD), K1.6 (SHD), K2.1 (SHD), K2.6 (SHD), K3.1 (SHD), K3.6 (SHD), K4.1 (SHD), K4.6 (SHD), K5.12, Q7.2 (S), Q8.2 (S), Q14.2 (S), Q15.2 (S), Q16.2 (S), Q17.2 (S), Q18.2 (S), R5.2, R24.2, R26.2, R27.2, R28.2, R30.2, R45.2, R46.2, R47.2, R48.2, R49.2, U1.2, U3.15 (GND), U7.4 (V-)
unnamed: C14.2, U4.1, U10.1
unnamed: C15.2, U7.7, U9.1
unnamed: D1.1 (K), R33.1
unnamed: D2.1 (K), R34.1
unnamed: D3.1 (K), R50.1
unnamed: D4.1 (K), R51.1
unnamed: D5.1 (K), R52.1
unnamed: D6.1 (K), R53.1
unnamed: D7.1 (K), R54.1
unnamed: D8.2 (A), K1.2 (-), Q14.3 (D), R50.2
unnamed: D9.2 (A), K2.2 (-), Q15.3 (D), R51.2
unnamed: D10.2 (A), K3.2 (-), Q16.3 (D), R52.2
unnamed: D11.2 (A), K4.2 (-), Q17.3 (D), R53.2
unnamed: D12.2 (A), K5.A1, Q18.3 (D), R54.2
unnamed: GD1.2, J6.1 (In), K1.4
unnamed: GD2.2, J7.1 (In), K2.4
unnamed: GD3.2, J8.1 (In), K3.4
unnamed: GD4.2, J9.1 (In), K4.4
unnamed: J10.1 (In), K1.3, K2.3, K3.3, K4.3, K5.11
unnamed: J11.3, U3.13 (R1IN)
unnamed: J11.4, U3.14 (T1OUT)
unnamed: Q1.3 (D), U2.2
unnamed: Q5.3 (D), U12.2
unnamed: Q6.3 (D), U13.2
unnamed: Q7.1 (G), R27.1, U12.4
unnamed: Q8.1 (G), R28.1, U13.4
unnamed: Q9.3 (D), U16.2
unnamed: Q10.3 (D), U17.2
unnamed: Q11.3 (D), U18.2
unnamed: Q12.3 (D), U19.2
unnamed: Q13.3 (D), U20.2
unnamed: Q14.1 (G), R45.1, U16.4
unnamed: Q15.1 (G), R46.1, U17.4
unnamed: Q16.1 (G), R47.1, U18.4
unnamed: Q17.1 (G), R48.1, U19.4
unnamed: Q18.1 (G), R49.1, U20.4
unnamed: R3.1, U2.1
unnamed: R4.2, U1.1
unnamed: R13.2, R14.1
unnamed: R15.2, R16.1
unnamed: R19.2, U12.1
unnamed: R20.2, U13.1
unnamed: R21.1, U8.2
unnamed: R21.2, R22.1
unnamed: R23.1, U11.2
unnamed: R23.2, R24.1
unnamed: R25.2, R26.1
unnamed: R29.2, R30.1
unnamed: R40.2, U16.1
unnamed: R41.2, U17.1
unnamed: R42.2, U18.1
unnamed: R43.2, U19.1
unnamed: R44.2, U20.1
unnamed: C4.1, U3.1 (C1+)
unnamed: C4.2, U3.3 (C1-)
unnamed: C6.1, U3.4 (C2+)
unnamed: C6.2, U3.5 (C2-)
unnamed: R4.1, U3.12 (R1OUT)
unnamed: R5.1, U2.4, U3.11 (T1IN)
unnamed: C8.1, U3.2 (VS+)
unnamed: C9.2, U3.6 (VS-)
unnamed: R12.2, U4.3 (+)
unnamed: C14.1, R13.1, U4.2 (-), U8.4
unnamed: R15.1, U4.5 (+), U9.4
unnamed: R11.2, U4.6 (-), U4.7
unnamed: R11.1, U5.4 (AIN0)
unnamed: R12.1, U6.6 (VOUTA)
unnamed: R25.1, U7.3 (+), U10.4
unnamed: R32.1, U7.1, U7.2 (-)
unnamed: R31.1, U7.5 (+)
unnamed: C15.1, R29.1, U7.6 (-), U11.4
unnamed: U8.1, U10.2
unnamed: U9.2, U11.1

Notes on the sheet:
Change U9 Pin 5 to 5V_ISO?
ADDR 0x48
Isolated CW and CCW control lines
Isolated RS232 to the SDA100 SteppIR Controller
Antenna Switching
ISOLATED
NON-ISOLATED
Raspberry Pi Connections
0V - 5V
I2C Isolated ADC 2V - 4.5V input from the Rotator Controller Heading Pin 4
Rotator Connections
Power input from external PSU Board
Raspberry Pi4 - 8GB
I2C Isolated DAC 0V - 5V output to the Rotator Controller Speed pin 3
Jumpers on pins 2&4 and 1&3

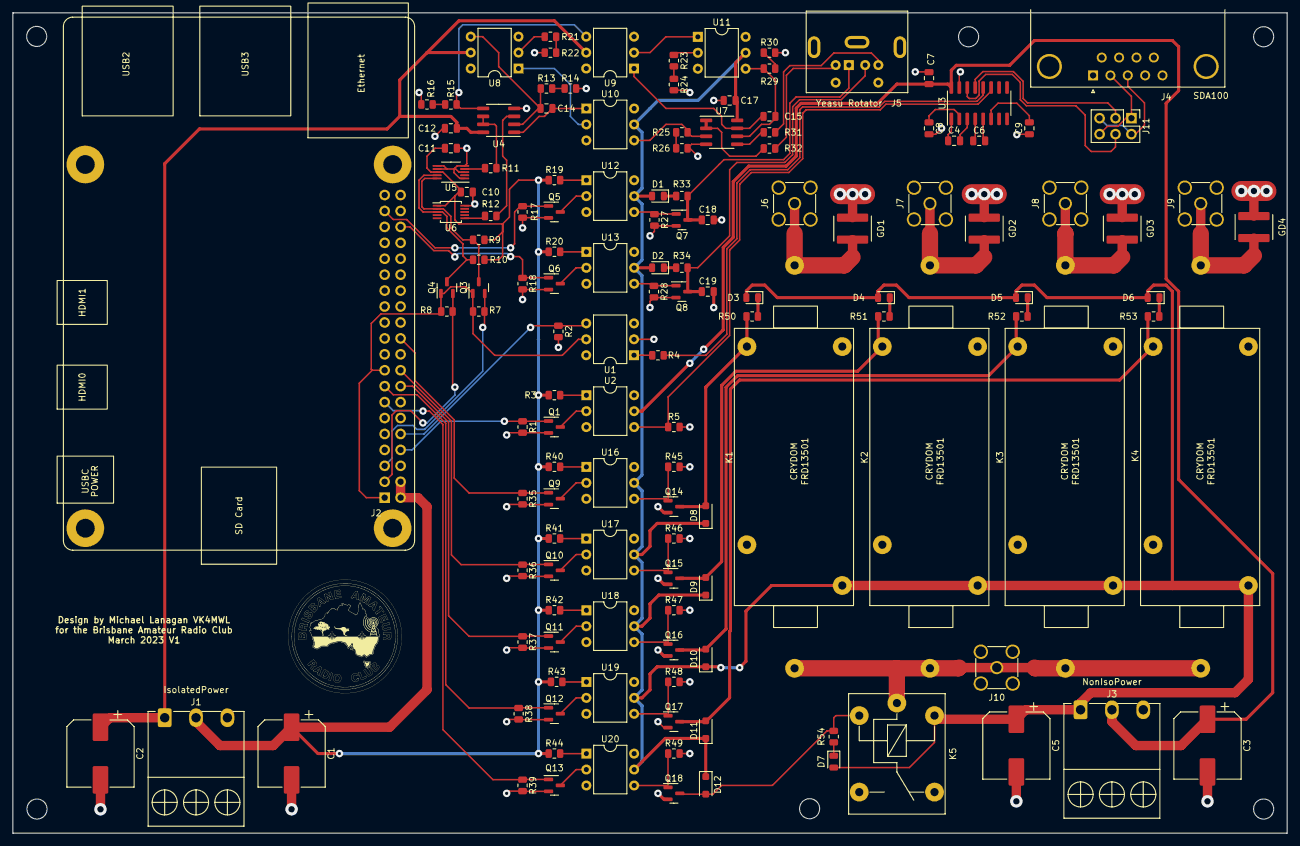
[picture p24: board RemoteHF.kicad_pcb from above]

Board: 2 copper layers, 203.2 x 130.8 mm, 137 parts (0 on the bottom side), 99 nets.
