mlanagan/RemoteHF/(commit log)

2023-06-03 Added latest export of NodeRed flow
2023-09-03 Latest Change August 2023 - PowerSupply
    [RemoteHF.kicad_pcb, RemoteHF.kicad_sch, Rotator Direction Scaling.xlsx]
2023-09-04 Updated BOM
2023-09-07 Added Power Supply Board
    [PowerSupply-B_Cu.gbr, PowerSupply-B_Mask.gbr, PowerSupply-B_Paste.gbr, PowerSupply-B_Silkscreen.gbr, PowerSupply-Edge_Cuts.gbr, PowerSupply-F_Cu.gbr, PowerSupply-F_Mask.gbr, PowerSupply-F_Paste.gbr]
2023-12-27 Updated Node Red JSON
    [Rotator Direction Scaling.xlsx]
2024-03-23 Added control of SteppIR when changing antennas
